natuition/Smoothieboard/N0127 SMOOTHIEBOARD MOTHERBOARD V10 RENDER.png

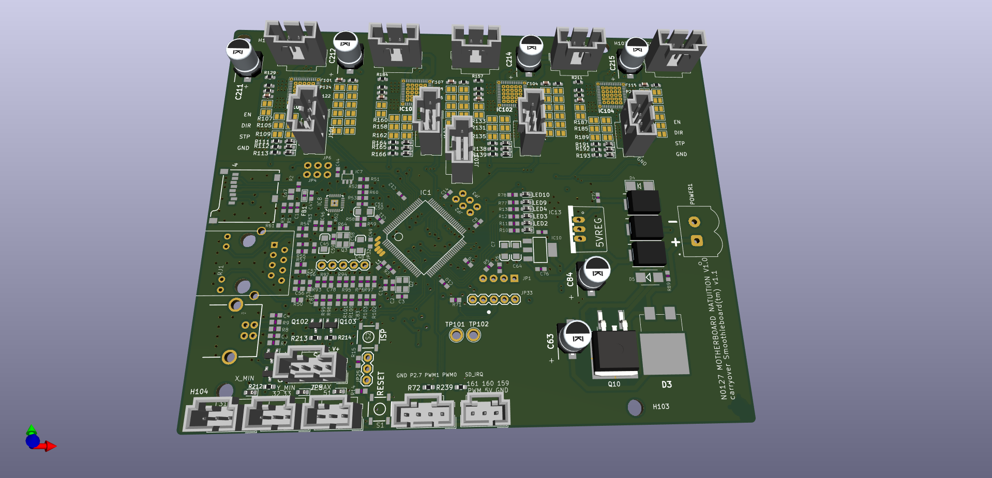
N0127 SMOOTHIEBOARD MOTHERBOARD V10 RENDER.png
