natuition/Smoothieboard/MOTHERBOARDV1.0 BOM TO PROTOELECTRONICS FROM RC3.xlsx

Ref | Qnty | Value | Fabricant | reference fabricant | Cmp name | Footprint | Description | Vendor
C1, C6, C8, C9, C10, C11, C12, C13, C14, C44, C46, C47, C51, C52, C53, C65, C76, C78, C79, C80, C81, C82, C83, | 23 | .1uF | Kyocera AVX | 0603ZC104KAT2A | C-EUC0603 | smoothieboard-5driver:C0603
C2, C3, C58, C59, | 4 | 12pF | MURATA | GJM0335G2A120GB01D | C-EUC0603 | smoothieboard-5driver:C0603
C4, C5, C54, C55, C56, C57, | 6 | 18pF | Kyocera AVX | 06035A180JAT2A | C-EUC0603 | smoothieboard-5driver:C0603
C7, C45, C50, C64, | 4 | 10uF | Kyocera AVX | TAJA106K016RNJ | CAP_POL1206 | smoothieboard-5driver:EIA3216
C48, | 1 | 1uF | Kyocera AVX | 08053C105JAT2A | CAP_POL1206 | smoothieboard-5driver:EIA3216
C49, | 1 | 470pF | Kyocera AVX | 06035A471JAT2A | C-EUC0603K | smoothieboard-5driver:C0603K
C63, C211, C212, C214, C215, C84 | 6 | 100uF | RUBYCON | 35TXV100M8X10.5 | EDK107M035A9HAA | SAMAC:CAPAE660X800N | Aluminum Electrolytic Capacitors - SMD 35V 100uF 20%
C67, | 1 | 1uF | Kyocera AVX | 08053C105JAT2A | C-EUC0805 | smoothieboard-5driver:C0805
C77, | 1 | .33uF | Kyocera AVX | 0603ZC334KAT2A | C-EUC0603 | smoothieboard-5driver:C0603
C101, C102, C104, C106, C107, C109, C115, C117, | 8 | 100n 6V3 | Kyocera AVX | 0603ZC104KAT2A | C-Device | Capacitor_SMD:C_0603_1608Metric_Pad1.08x0.95mm_HandSolder
D1, D2, D6, | 3 | MBRS330T3G | ON SEMI | MBRS330T3G | MBRS330T3G | SAMAC:DIOM7958X256N
D3, | 1 | VS-6TQ045S-M3 | VISHAY | VS-6TQ045S-M3 | VS-6TQ045S-M3 | SAMAC:VS6TQ045SM3 | Diode Schottky 45V 6A 3-Pin(2+Tab) D2PAK Tube
D4, | 1 | B1100-13-F | MULTICOMP PRO | B1100-13-F | DIODESMA | smoothieboard-5driver:SMADIODE
D5, | 1 | 15v | MCC | 3SMBJ5929B-TP | ZENER-DIODESMB | smoothieboard-5driver:SMB
D101, D102, D103, D104, D105, D106, D107, D108, D109, D110, D111, D112, LED1, LED2, LED3, LED4, LED9, LED10, LED101,LED102,LED103 | 21 | 150060SS75000 | WURTH ELEKTRONIK | 150060SS75000 | LED-Device | Diode_SMD:D_0603_1608Metric_Pad1.05x0.95mm_HandSolder
FB1, | 1 | FERRITE | Laird-Signal Integrity Products | LI0603G121R-10 | FERRITE | smoothieboard-5driver:0603
IC1, | 1 | LPC1769 | NATUITION | LPC1769 | LPC1768 | smoothieboard-5driver:LQFP100
IC7, | 1 | 74LVC1G04 | TI | SN74LVC1G04DBVR | 74LVC1G04 | smoothieboard-5driver:SOT23-5
IC8, | 1 | LAN8720 | NATUITION | 886-LAN8720AI-CP | LAN8720 | smoothieboard-5driver:QFN24_4MM
IC10, | 1 | LM1117-3.3V | NATUITION | LM1117IMP-3.3/NOPB | V_REG_LM1117SOT223 | smoothieboard-5driver:SOT223
IC13, | 1 | R-78E-5.0 | NATUITION | R-78E5.0-0.5 | R-78 | smoothieboard-5driver:R-78
IC101, IC102, IC103, IC104, | 4 | ~ | NATUITION | TB67S289FTG,EL | TB67S249FTG,EL-TB67S249FTG_EL | TB67S249FTG:QFN50P700X700X100-49N-D
J1, J2, J3, J4, J5, J101, J102, J103, J104, J105, J106, JP5 | 12 | SL 70543_0038 | MOLEX | 70543_0038 | M041X04_NO_SILK | Connector_Molex:Molex_SL_171971-0004_1x04_P2.54mm_Vertical
JP16, JP20, JP22, JP26, | 4 | SL 70543-0002 | MOLEX | 70543-0002 | M03POLAR | Connector_Molex:Molex_SL_171971-0003_1x03_P2.54mm_Vertical
L1, | 1 | INDUCTOR0603 | MURATA | LQW18AN39NJ8ZD | INDUCTOR0603 | smoothieboard-5driver:0603
POWER1, | 1 | 1146730000 | WEIDMULLER | 1148630000 | 1146730000 | OMNIMATE1148630000:1146730000
Q1, Q101,Q102,Q103 | 4 | CANAL P | NEXPERIA | BSS84,215 | BSL207SP | smoothieboard-5driver:SC74_INFINEON
Q2, | 1 | 12MHz | Kyocera AVX | CX3225SB12000H0FLJCC | CRYSTALTHIN | smoothieboard-5driver:CRYSTAL_3.2X2.5
Q3, | 1 | 25MHz | Kyocera AVX | CX3225SB25000H0FLJCC | CRYSTALTHIN | smoothieboard-5driver:CRYSTAL_3.2X2.5
Q10, | 1 | CANAL P | INFINEON | AUIRF4905S | SPD30P06PTO252 | smoothieboard-5driver:TO252
R1, R2, R3, R14, R15, R53, R62, R71, R89, R72, R239, R128, R156, R183, R210, | 15 | 10K | TE CONNECTIVITY | CRGCQ0603J10K | R-US_R0603 | smoothieboard-5driver:R0603
R5, R6, | 2 | 2.2k | MULTICOMP PRO | MC0603SAF2201T5E | R-US_R0603 | smoothieboard-5driver:R0603
R7, R52, | 2 | 1.5K | MULTICOMP PRO | MC0603SAF1501T5E | R-US_R0603 | smoothieboard-5driver:R0603
R8, R9, | 2 | 33R | PANASONIC | ERJ-UP3F33R0V | R-US_R0603 | smoothieboard-5driver:R0603
R10, R11, R12, R13, R77, R93, R94, R96, R98, R100, R102, R212,R213,214 | 14 | 1k | YAGEO | AC0603JR-071KL | R-US_R0603 | smoothieboard-5driver:R0603
R50, R61, | 2 | 330R | YAGEO | RC0603FR-07330RL | R-US_R0603 | smoothieboard-5driver:R0603
R51, R58, R59, R60, | 4 | 22R | PANASONIC | ERJ-UP3F22R0V | R-US_R0603 | smoothieboard-5driver:R0603
R54, R55, R56, R57, | 4 | 49.9R | YAGEO | RC0603FR-0749R9L | R-US_R0603 | smoothieboard-5driver:R0603
R63, | 1 | 12.1K | TE | CPF0603F12K1C1 | R-US_R0603 | smoothieboard-5driver:R0603
R64, | 1 | 1M | VISHAY | CRCW06031M00FKEAHP | R-US_R0603 | smoothieboard-5driver:R0603
R78, | 1 | 8.2K | MULTICOMP PRO | MC0603SAF8201T5E | R-US_R0603 | smoothieboard-5driver:R0603
R92, R95, R97, R99, R101, R103, | 6 | 5k6 | VISHAY | CRCW06035K60FKEA | R-US_R0603 | smoothieboard-5driver:R0603
R111, R112, R113, R137, R138, R139, R164, R165, R166, R191, R192, R193, | 12 | 470R | VISHAY | CRCW0603470RJNEBC | R-Device | Resistor_SMD:R_0603_1608Metric_Pad0.98x0.95mm_HandSolder
R126, R153, R180, R207, | 4 | 100K | PANASONIC | ERJ-3EKF1003V | R-Device | Resistor_SMD:R_0603_1608Metric_Pad0.98x0.95mm_HandSolder
R129, R157, R184, R211, | 4 | 50K | BOURNS | CR0603-FX-4992ELF | R-Device | Resistor_SMD:R_0603_1608Metric_Pad0.98x0.95mm_HandSolder
RJ1, | 1 | HR911105A | NATUITION | HR911105A | HR911105A | smoothieboard-5driver:HR911105A
S1, S2, | 2 | TAC_SWITCHSMD | CTS Electrocomponents | 223AMVAAR | TAC_SWITCHSMD | smoothieboard-5driver:TACTILE_SWITCH_SMD
U1, | 1 | USD-SOCKETNEW | GCT | MEM2061-01-188-00-A | USD-SOCKETNEW | smoothieboard-5driver:MICRO-SD-SOCKET-PP
X14, | 1 | USBPTH | SPARKFUN | PRT-00139 | USBPTH | smoothieboard-5driver:USB-B-PTH
