natuition/Smoothieboard/MOTHERBOARD.kicad_sch

## KiCad design MOTHERBOARD.kicad_sch (2022-07-20)

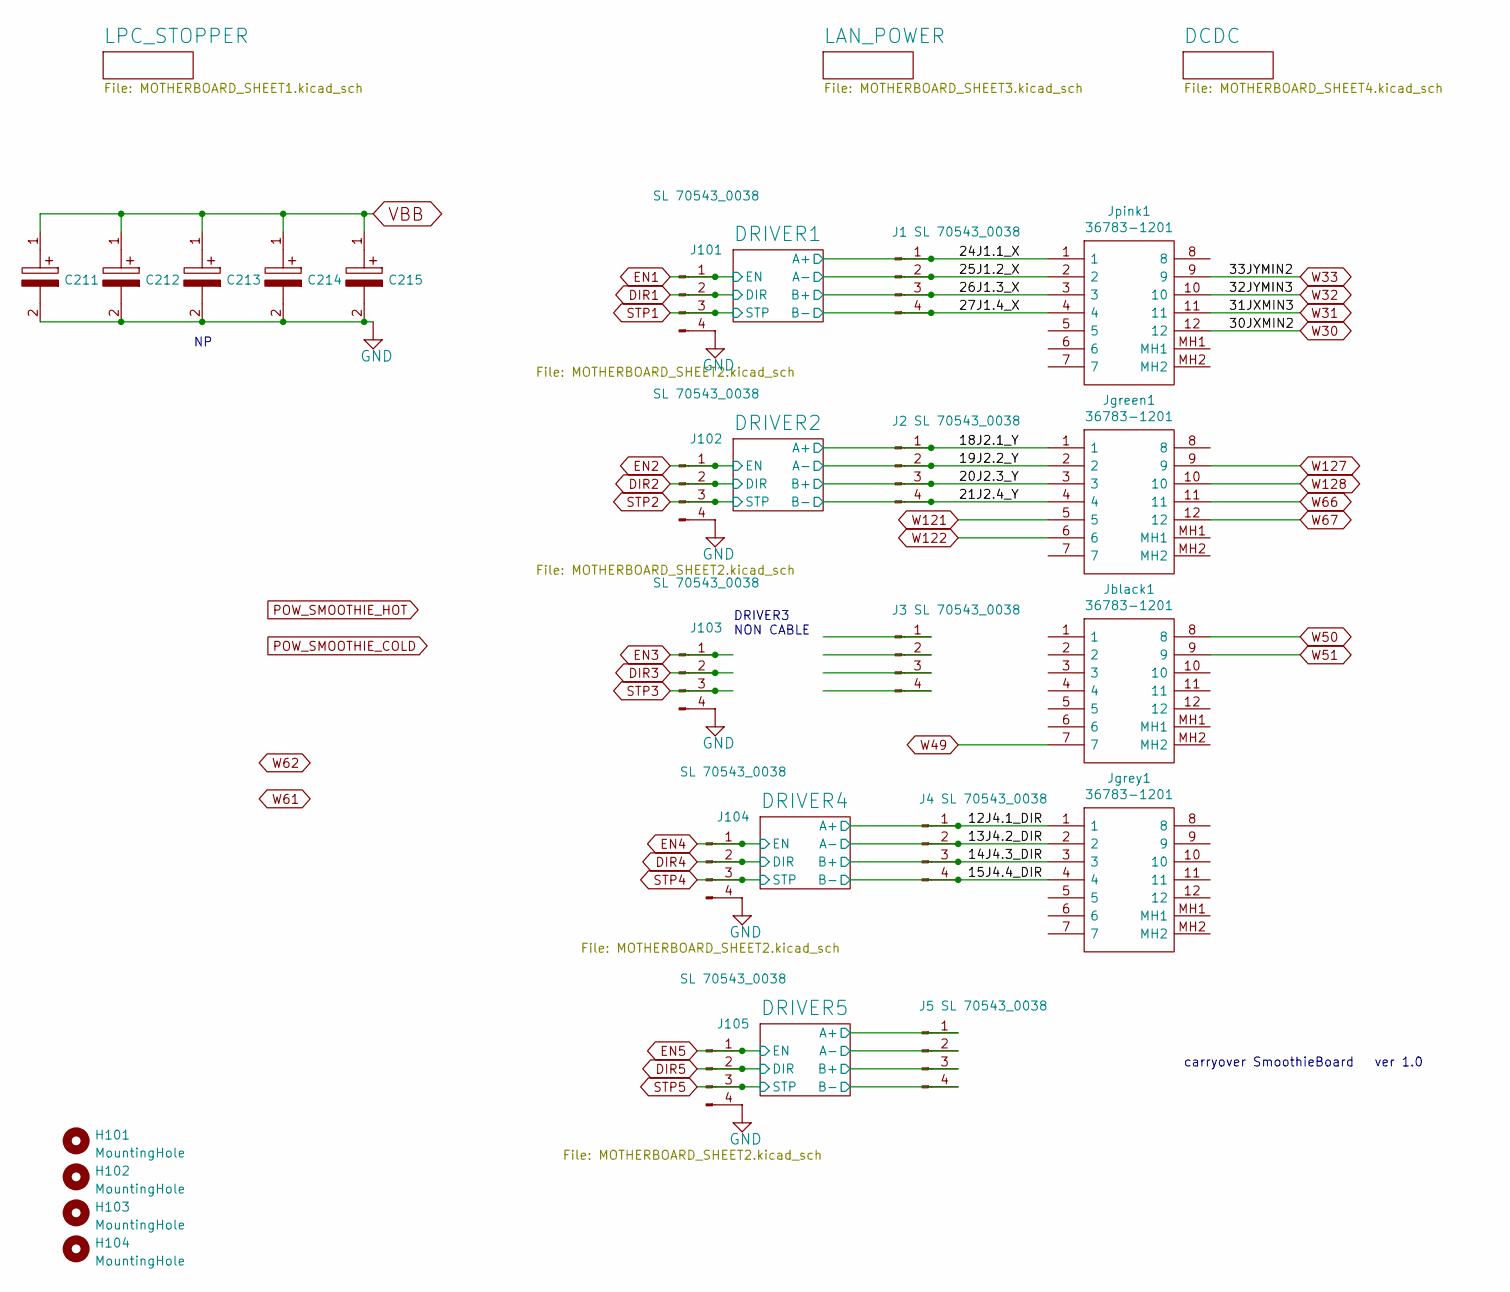
[picture p2: schematic MOTHERBOARD.kicad_sch]

Parts:
C211, C212, C214, C215: EDK107M035A9HAA; CAPAE660X800N; Mouser Part Number 80-EDK107M035A9HAA
C213: EDK107M035A9HAA; Mouser Part Number 80-EDK107M035A9HAA
H101, H102, H103, H104: MountingHole; MountingHole_3.7mm_NATUITION_SMOOTHIE
J1, J2, J3, J4, J5, J101, J102, J103, J104, J105: SL 70543_0038; Molex_SL_171971-0004_1x04_P2.54mm_Vertical
Jblack1: 36783-1201; 367831201; Mouser Part Number 538-36783-1201
Jgreen1: 36783-1201; 367831201; Mouser Part Number 538-36783-1201
Jgrey1: 36783-1201; 367831201; Mouser Part Number 538-36783-1201
Jpink1: 36783-1201; 367831201; Mouser Part Number 538-36783-1201

Connections:
12J4.1_DIR: J4.1, Jgrey1.1
13J4.2_DIR: J4.2, Jgrey1.2
14J4.3_DIR: J4.3, Jgrey1.3
15J4.4_DIR: J4.4, Jgrey1.4
18J2.1_Y: J2.1, Jgreen1.1
19J2.2_Y: J2.2, Jgreen1.2
20J2.3_Y: J2.3, Jgreen1.3
21J2.4_Y: J2.4, Jgreen1.4
24J1.1_X: J1.1, Jpink1.1
25J1.2_X: J1.2, Jpink1.2
26J1.3_X: J1.3, Jpink1.3
27J1.4_X: J1.4, Jpink1.4
A+: J5.1
A-: J5.2
B+: J5.3
B-: J5.4
DIR1: J101.2
DIR2: J102.2
DIR3: J103.2
DIR4: J104.2
DIR5: J105.2
EN1: J101.1
EN2: J102.1
EN3: J103.1
EN4: J104.1
EN5: J105.1
GND: C211.2, C212.2, C213.2, C214.2, C215.2, J101.4, J102.4, J103.4, J104.4, J105.4
STP1: J101.3
STP2: J102.3
STP3: J103.3
STP4: J104.3
STP5: J105.3
VBB: C211.1, C212.1, C213.1, C214.1, C215.1
W30: Jpink1.12
W31: Jpink1.11
W32: Jpink1.10
W33: Jpink1.9
W49: Jblack1.7
W50: Jblack1.8
W51: Jblack1.9
W66: Jgreen1.11
W67: Jgreen1.12
W121: Jgreen1.5
W122: Jgreen1.6
W127: Jgreen1.9
W128: Jgreen1.10

Notes on the sheet:
carryover SmoothieBoard ver 1.0
DRIVER3 NON CABLE
