natuition/Smoothieboard/MOTHERBOARD_SHEET1.kicad_sch

## KiCad design MOTHERBOARD_SHEET1.kicad_sch (2022-07-20)

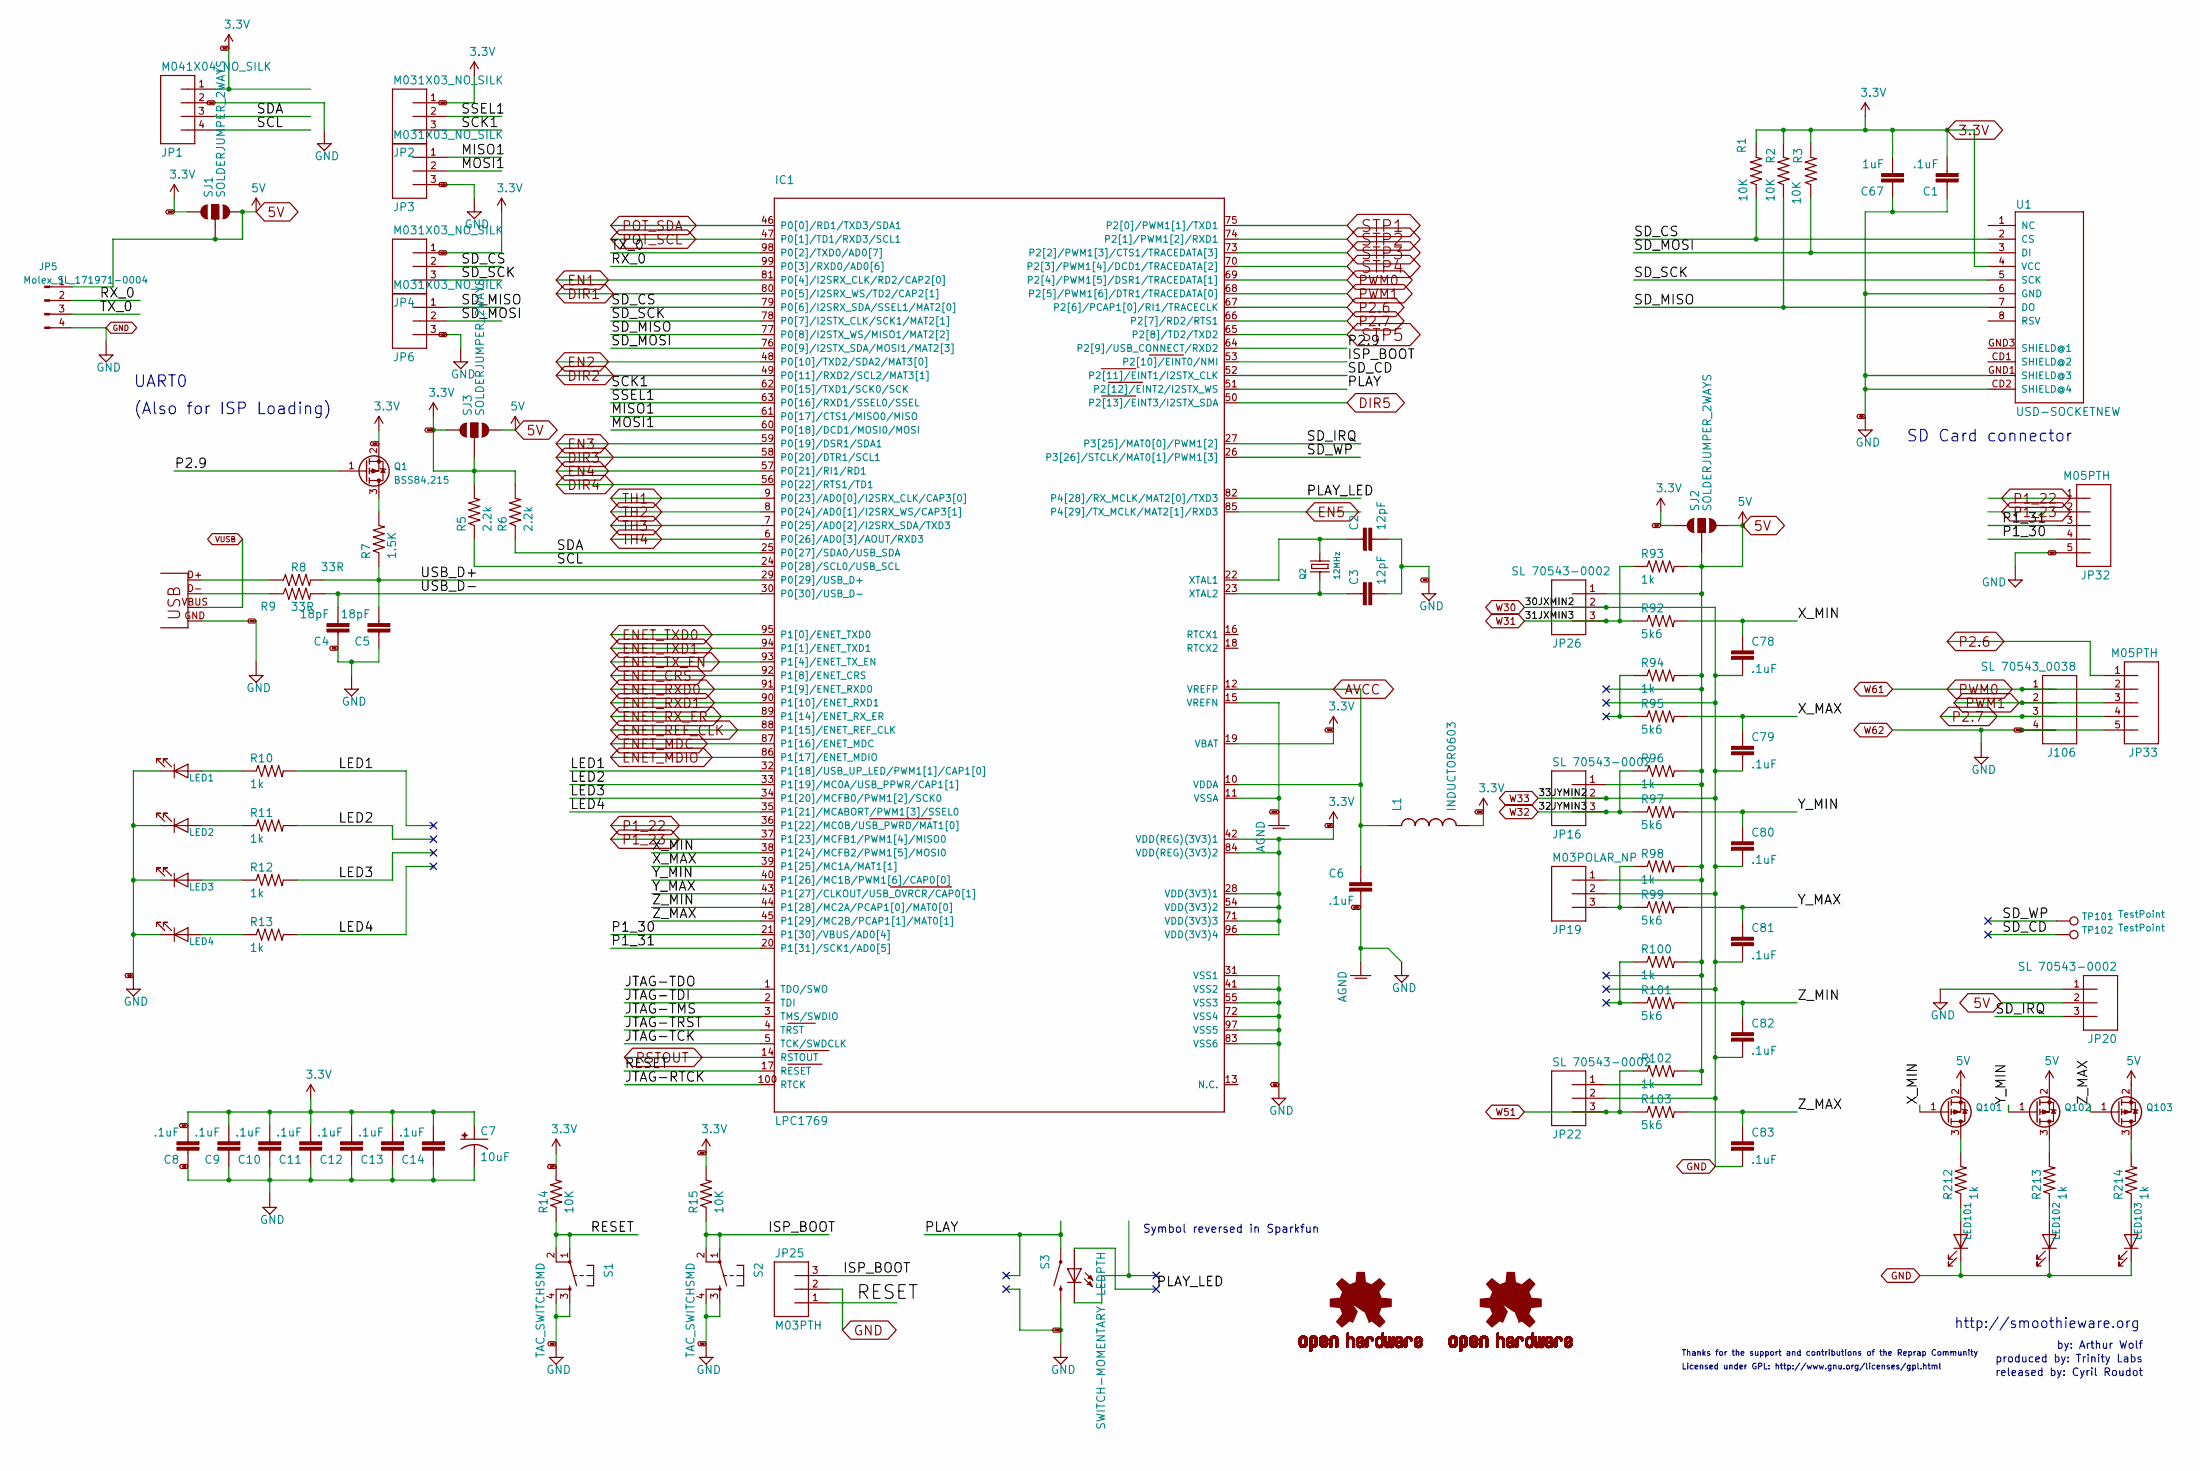
[picture p3: schematic MOTHERBOARD_SHEET1.kicad_sch]

Parts:
C1, C6, C8, C9, C10, C11, C12, C13, C14, C78, C79, C80, C81, C82, C83: .1uF; C0603
C2, C3: 12pF; C0603
C4, C5: 18pF; C0603
C7: 10uF; EIA3216
C67: 1uF; C0805
IC1: LPC1769; LQFP100
J106: SL 70543_0038; Molex_SL_171971-0004_1x04_P2.54mm_Vertical
JP1: M041X04_NO_SILK; 1X04_NO_SILK
JP2, JP3, JP4, JP6: M031X03_NO_SILK; 1X03_NO_SILK
JP5: Molex_SL_171971-0004; Molex_SL_171971-0004_1x04_P2.54mm_Vertical
JP16, JP20, JP22, JP26: SL 70543-0002; Molex_SL_171971-0003_1x03_P2.54mm_Vertical
JP19: M03POLAR_NP
JP25: M03PTH; 1X03
JP32, JP33: M05PTH; 1X05
L1: INDUCTOR0603; 0603
LED1, LED2, LED3, LED4, LED101, LED102, LED103: 150060SS75000; D_0603_1608Metric_Pad1.05x0.95mm_HandSolder
Q1, Q101, Q102, Q103: BSS84,215; SOT-23
Q2: 12MHz; CRYSTAL_3.2X2.5
R1, R2, R3, R14, R15: 10K; R0603
R5, R6: 2.2k; R0603
R7: 1.5K; R0603
R8, R9: 33R; R0603
R10, R11, R12, R13, R93, R94, R96, R98, R100, R102: 1k; R0603
R92, R95, R97, R99, R101, R103: 5k6; R0603
R212, R213, R214: 1k; R_0603_1608Metric_Pad0.98x0.95mm_HandSolder
S1, S2: TAC_SWITCHSMD; TACTILE_SWITCH_SMD
S3: SWITCH-MOMENTARY-LEDPTH
SJ1, SJ2, SJ3: SOLDERJUMPER_2WAYS; SJ_3
TP101, TP102: TestPoint; TestPoint_Plated_Hole_D2.0mm
U1: USD-SOCKETNEW; MICRO-SD-SOCKET-PP
U$101, U$102: OSHW-LOGOH; OSHW-LOGO-HUGE
X14: USBPTH; USB-B-PTH

Connections:
3.3V: C1.2, C7.A (+), C8.2, C9.2, C10.2, C11.2, C12.2, C13.2, C14.2, C67.2, IC1.19 (VBAT), IC1.28 (VDD(3V3)1), IC1.42 (VDD(REG)(3V3)1), IC1.54 (VDD(3V3)2), IC1.71 (VDD(3V3)3), IC1.84 (VDD(REG)(3V3)2), IC1.96 (VDD(3V3)4), JP1.1, JP2.1, JP4.1, L1.2, Q1.2 (S), R1.2, R2.2, R3.2, R5.2, R6.2, R14.2, R15.2, SJ1.1, SJ2.1, SJ3.1, SJ3.2, U1.4 (VCC)
5V: JP5.1, JP16.1, JP19.1, JP20.2, JP22.1, JP26.1, Q101.2 (S), Q102.2 (S), Q103.2 (S), R93.2, R94.2, R96.2, R98.2, R100.2, R102.2, SJ1.2, SJ1.3, SJ2.2, SJ2.3, SJ3.3
AGND: C1.1, C2.2, C3.2, C4.1, C5.1, C6.2, C7.C (-), C8.1, C9.1, C10.1, C11.1, C12.1, C13.1, C14.1, C67.1, C78.2, C79.2, C80.2, C81.2, C82.2, C83.2, IC1.11 (VSSA), IC1.15 (VREFN), IC1.31 (VSS1), IC1.41 (VSS2), IC1.55 (VSS3), IC1.72 (VSS4), IC1.83 (VSS6), IC1.97 (VSS5), J106.4, JP1.2, JP3.3, JP5.4, JP6.3, JP16.2, JP19.2, JP20.1, JP22.2, JP25.2, JP26.2, JP32.5, JP33.5, LED1.1 (K), LED2.1 (K), LED3.1 (K), LED4.1 (K), LED101.1 (K), LED102.1 (K), LED103.1 (K), S1.3, S1.4, S2.3, S2.4, S3.2, U1.6 (GND), U1.CD2 (SHIELD@4), U1.GND1 (SHIELD@3), X14.GND
AVCC: C6.1, IC1.10 (VDDA), IC1.12 (VREFP), L1.1
DIR1: IC1.80 (P0[5]/I2SRX_WS/TD2/CAP2[1])
DIR2: IC1.49 (P0[11]/RXD2/SCL2/MAT3[1])
DIR3: IC1.58 (P0[20]/DTR1/SCL1)
DIR4: IC1.56 (P0[22]/RTS1/TD1)
DIR5: IC1.50 (P2[13]/EINT3/I2STX_SDA)
EN1: IC1.81 (P0[4]/I2SRX_CLK/RD2/CAP2[0])
EN2: IC1.48 (P0[10]/TXD2/SDA2/MAT3[0])
EN3: IC1.59 (P0[19]/DSR1/SDA1)
EN4: IC1.57 (P0[21]/RI1/RD1)
EN5: IC1.85 (P4[29]/TX_MCLK/MAT2[1]/RXD3)
ENET_CRS: IC1.92 (P1[8]/ENET_CRS)
ENET_MDC: IC1.87 (P1[16]/ENET_MDC)
ENET_MDIO: IC1.86 (P1[17]/ENET_MDIO)
ENET_REF_CLK: IC1.88 (P1[15]/ENET_REF_CLK)
ENET_RXD0: IC1.91 (P1[9]/ENET_RXD0)
ENET_RXD1: IC1.90 (P1[10]/ENET_RXD1)
ENET_RX_ER: IC1.89 (P1[14]/ENET_RX_ER)
ENET_TXD0: IC1.95 (P1[0]/ENET_TXD0)
ENET_TXD1: IC1.94 (P1[1]/ENET_TXD1)
ENET_TX_EN: IC1.93 (P1[4]/ENET_TX_EN)
ISP_BOOT: IC1.53 (P2[10]/EINT0/NMI), JP25.3, R15.1, S2.1, S2.2
JTAG-RTCK: IC1.100 (RTCK)
JTAG-TCK: IC1.5 (TCK/SWDCLK)
JTAG-TDI: IC1.2 (TDI)
JTAG-TDO: IC1.1 (TDO/SWO)
JTAG-TMS: IC1.3 (TMS/SWDIO)
JTAG-TRST: IC1.4 (TRST)
LED1: IC1.32 (P1[18]/USB_UP_LED/PWM1[1]/CAP1[0]), R10.2
LED2: IC1.33 (P1[19]/MC0A/USB_PPWR/CAP1[1]), R11.2
LED3: IC1.34 (P1[20]/MCFB0/PWM1[2]/SCK0), R12.2
LED4: IC1.35 (P1[21]/MCABORT/PWM1[3]/SSEL0), R13.2
MISO1: IC1.61 (P0[17]/CTS1/MISO0/MISO), JP3.1
MOSI1: IC1.60 (P0[18]/DCD1/MOSI0/MOSI), JP3.2
unnamed: C2.1, IC1.22 (XTAL1), Q2.2
unnamed: C3.1, IC1.23 (XTAL2), Q2.1
unnamed: JP19.3, R98.1, R99.1
unnamed: LED1.2 (A), R10.1
unnamed: LED2.2 (A), R11.1
unnamed: LED3.2 (A), R12.1
unnamed: LED4.2 (A), R13.1
unnamed: LED101.2 (A), R212.1
unnamed: LED102.2 (A), R213.1
unnamed: LED103.2 (A), R214.1
unnamed: Q1.3 (D), R7.2
unnamed: Q101.3 (D), R212.2
unnamed: Q102.3 (D), R213.2
unnamed: Q103.3 (D), R214.2
unnamed: R8.1, X14.D+
unnamed: R9.1, X14.D-
unnamed: R94.1, R95.1
unnamed: R100.1, R101.1
P1_22: IC1.36 (P1[22]/MC0B/USB_PWRD/MAT1[0]), JP32.1
P1_23: IC1.37 (P1[23]/MCFB1/PWM1[4]/MISO0), JP32.2
P1_30: IC1.21 (P1[30]/VBUS/AD0[4]), JP32.4
P1_31: IC1.20 (P1[31]/SCK1/AD0[5]), JP32.3
P2.6: IC1.67 (P2[6]/PCAP1[0]/RI1/TRACECLK), JP33.1
P2.7: IC1.66 (P2[7]/RD2/RTS1), J106.3, JP33.4
P2.9: IC1.64 (P2[9]/USB_CONNECT/RXD2), Q1.1 (G)
PLAY: IC1.51 (P2[12]/EINT2/I2STX_WS), S3.4 (1)
PLAY_LED: IC1.82 (P4[28]/RX_MCLK/MAT2[0]/TXD3), S3.A
POT_SCL: IC1.47 (P0[1]/TD1/RXD3/SCL1)
POT_SDA: IC1.46 (P0[0]/RD1/TXD3/SDA1)
PWM0: IC1.69 (P2[4]/PWM1[5]/DSR1/TRACEDATA[1]), J106.1, JP33.2
PWM1: IC1.68 (P2[5]/PWM1[6]/DTR1/TRACEDATA[0]), J106.2, JP33.3
RESET: IC1.17 (RESET), JP25.1, R14.1, S1.1, S1.2
RSTOUT: IC1.14 (RSTOUT)
RX_0: IC1.99 (P0[3]/RXD0/AD0[6]), JP5.2
SCK1: IC1.62 (P0[15]/TXD1/SCK0/SCK), JP2.3
SCL: IC1.24 (P0[28]/SCL0/USB_SCL), JP1.4, R5.1
SDA: IC1.25 (P0[27]/SDA0/USB_SDA), JP1.3, R6.1
SD_CD: IC1.52 (P2[11]/EINT1/I2STX_CLK), TP102.1
SD_CS: IC1.79 (P0[6]/I2SRX_SDA/SSEL1/MAT2[0]), JP4.2, R1.1, U1.2 (CS)
SD_IRQ: IC1.27 (P3[25]/MAT0[0]/PWM1[2]), JP20.3
SD_MISO: IC1.77 (P0[8]/I2STX_WS/MISO1/MAT2[2]), JP6.1, R2.1, U1.7 (DO)
SD_MOSI: IC1.76 (P0[9]/I2STX_SDA/MOSI1/MAT2[3]), JP6.2, R3.1, U1.3 (DI)
SD_SCK: IC1.78 (P0[7]/I2STX_CLK/SCK1/MAT2[1]), JP4.3, U1.5 (SCK)
SD_WP: IC1.26 (P3[26]/STCLK/MAT0[1]/PWM1[3]), TP101.1
SSEL1: IC1.63 (P0[16]/RXD1/SSEL0/SSEL), JP2.2
STP1: IC1.75 (P2[0]/PWM1[1]/TXD1)
STP2: IC1.74 (P2[1]/PWM1[2]/RXD1)
STP3: IC1.73 (P2[2]/PWM1[3]/CTS1/TRACEDATA[3])
STP4: IC1.70 (P2[3]/PWM1[4]/DCD1/TRACEDATA[2])
STP5: IC1.65 (P2[8]/TD2/TXD2)
TH1: IC1.9 (P0[23]/AD0[0]/I2SRX_CLK/CAP3[0])
TH2: IC1.8 (P0[24]/AD0[1]/I2SRX_WS/CAP3[1])
TH3: IC1.7 (P0[25]/AD0[2]/I2SRX_SDA/TXD3)
TH4: IC1.6 (P0[26]/AD0[3]/AOUT/RXD3)
TX_0: IC1.98 (P0[2]/TXD0/AD0[7]), JP5.3
USB_D+: C5.2, IC1.29 (P0[29]/USB_D+), R7.1, R8.2
USB_D-: C4.2, IC1.30 (P0[30]/USB_D-), R9.2
VUSB: X14.VBUS
W31: JP26.3, R92.1, R93.1
W32: JP16.3, R96.1, R97.1
W51: JP22.3, R102.1, R103.1
X_MAX: C79.1, IC1.39 (P1[25]/MC1A/MAT1[1]), R95.2
X_MIN: C78.1, IC1.38 (P1[24]/MCFB2/PWM1[5]/MOSI0), Q101.1 (G), R92.2
Y_MAX: C81.1, IC1.43 (P1[27]/CLKOUT/USB_OVRCR/CAP0[1]), R99.2
Y_MIN: C80.1, IC1.40 (P1[26]/MC1B/PWM1[6]/CAP0[0]), Q102.1 (G), R97.2
Z_MAX: C83.1, IC1.45 (P1[29]/MC2B/PCAP1[1]/MAT0[1]), Q103.1 (G), R103.2
Z_MIN: C82.1, IC1.44 (P1[28]/MC2A/PCAP1[0]/MAT0[0]), R101.2

Notes on the sheet:
(Also for ISP Loading)
Thanks for the support and contributions of the Reprap Community
SD Card connector
http://smoothieware.org
UART0
released by: Cyril Roudot
Licensed under GPL: http://www.gnu.org/licenses/gpl.html
by: Arthur Wolf
Symbol reversed in Sparkfun
produced by: Trinity Labs
