natuition/Smoothieboard/MOTHERBOARD_SHEET2.kicad_sch

## KiCad design MOTHERBOARD_SHEET2.kicad_sch (2022-07-20)

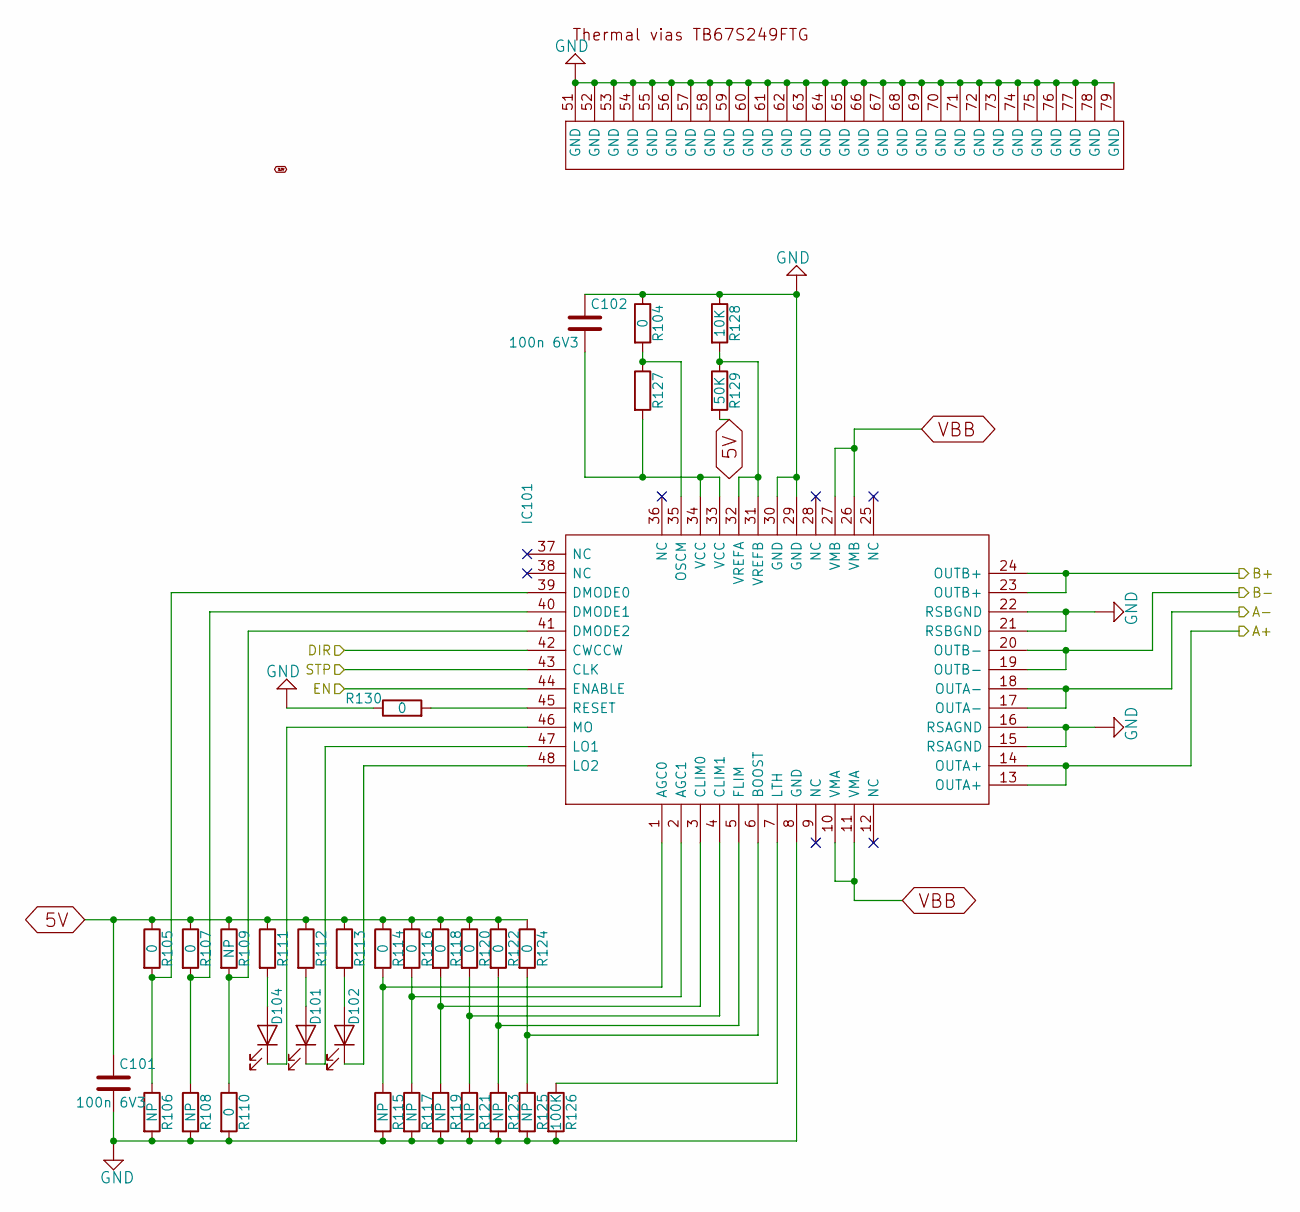
[picture p4: schematic MOTHERBOARD_SHEET2.kicad_sch]

Parts:
C101, C102: 100n 6V3; C_0603_1608Metric_Pad1.08x0.95mm_HandSolder
D101, D102, D104: 150060SS75000; D_0603_1608Metric_Pad1.05x0.95mm_HandSolder
IC101: QFN50P700X700X100-49N-D; Mouser Part Number 757-TB67S249FTGEL
R104, R105, R107, R110, R114, R116, R118, R120, R122, R124, R130: 0; SolderJumper-2_P1.3mm_Bridged_Pad1.0x1.5mm
R106, R108: NP; SolderJumper-2_P1.3mm_Bridged_Pad1.0x1.5mm
R109, R115, R117, R119, R121, R123, R125: NP; SolderJumper-2_P1.3mm_Open_Pad1.0x1.5mm
R111, R112, R113: CRCW0603470RJNEBC; R_0603_1608Metric_Pad0.98x0.95mm_HandSolder
R126: 100K; R_0603_1608Metric_Pad0.98x0.95mm_HandSolder
R127: R_0603_1608Metric_Pad0.98x0.95mm_HandSolder
R128: 10K; R_0603_1608Metric_Pad0.98x0.95mm_HandSolder
R129: 50K; R_0603_1608Metric_Pad0.98x0.95mm_HandSolder

Connections:
5V: C101.1, R105.1, R107.1, R109.1, R111.1, R112.1, R113.1, R114.1, R116.1, R118.1, R120.1, R122.1, R124.1, R129.2
A+: IC101.13 (OUTA+), IC101.14 (OUTA+)
A-: IC101.17 (OUTA-), IC101.18 (OUTA-)
B+: IC101.23 (OUTB+), IC101.24 (OUTB+)
B-: IC101.19 (OUTB-), IC101.20 (OUTB-)
DIR: IC101.42 (CWCCW)
EN: IC101.44 (ENABLE)
GND: C101.2, C102.1, IC101.8 (GND), IC101.15 (RSAGND), IC101.16 (RSAGND), IC101.21 (RSBGND), IC101.22 (RSBGND), IC101.29 (GND), IC101.30 (GND), IC101.51 (GND), IC101.52 (GND), IC101.53 (GND), IC101.54 (GND), IC101.55 (GND), IC101.56 (GND), IC101.57 (GND), IC101.58 (GND), IC101.59 (GND), IC101.60 (GND), IC101.61 (GND), IC101.62 (GND), IC101.63 (GND), IC101.64 (GND), IC101.65 (GND), IC101.66 (GND), IC101.67 (GND), IC101.68 (GND), IC101.69 (GND), IC101.70 (GND), IC101.71 (GND), IC101.72 (GND), IC101.73 (GND), IC101.74 (GND), IC101.75 (GND), IC101.76 (GND), IC101.77 (GND), IC101.78 (GND), IC101.79 (GND), R104.1, R106.2, R108.2, R110.2, R115.2, R117.2, R119.2, R121.2, R123.2, R125.2, R126.2, R128.1, R130.1
unnamed: C102.2, IC101.33 (VCC), IC101.34 (VCC), R127.2
unnamed: D101.1 (K), IC101.47 (LO1)
unnamed: D101.2 (A), R112.2
unnamed: D102.1 (K), IC101.48 (LO2)
unnamed: D102.2 (A), R113.2
unnamed: D104.1 (K), IC101.46 (MO)
unnamed: D104.2 (A), R111.2
unnamed: IC101.1 (AGC0), R114.2, R115.1
unnamed: IC101.2 (AGC1), R116.2, R117.1
unnamed: IC101.3 (CLIM0), R118.2, R119.1
unnamed: IC101.4 (CLIM1), R120.2, R121.1
unnamed: IC101.5 (FLIM), R122.2, R123.1
unnamed: IC101.6 (BOOST), R124.2, R125.1
unnamed: IC101.7 (LTH), R126.1
unnamed: IC101.31 (VREFB), IC101.32 (VREFA), R128.2, R129.1
unnamed: IC101.35 (OSCM), R104.2, R127.1
unnamed: IC101.39 (DMODE0), R105.2, R106.1
unnamed: IC101.40 (DMODE1), R107.2, R108.1
unnamed: IC101.41 (DMODE2), R109.2, R110.1
unnamed: IC101.45 (RESET), R130.2
STP: IC101.43 (CLK)
VBB: IC101.10 (VMA), IC101.11 (VMA), IC101.26 (VMB), IC101.27 (VMB)
