natuition/Smoothieboard/MOTHERBOARD_SHEET3.kicad_sch

## KiCad design MOTHERBOARD_SHEET3.kicad_sch (2022-07-20)

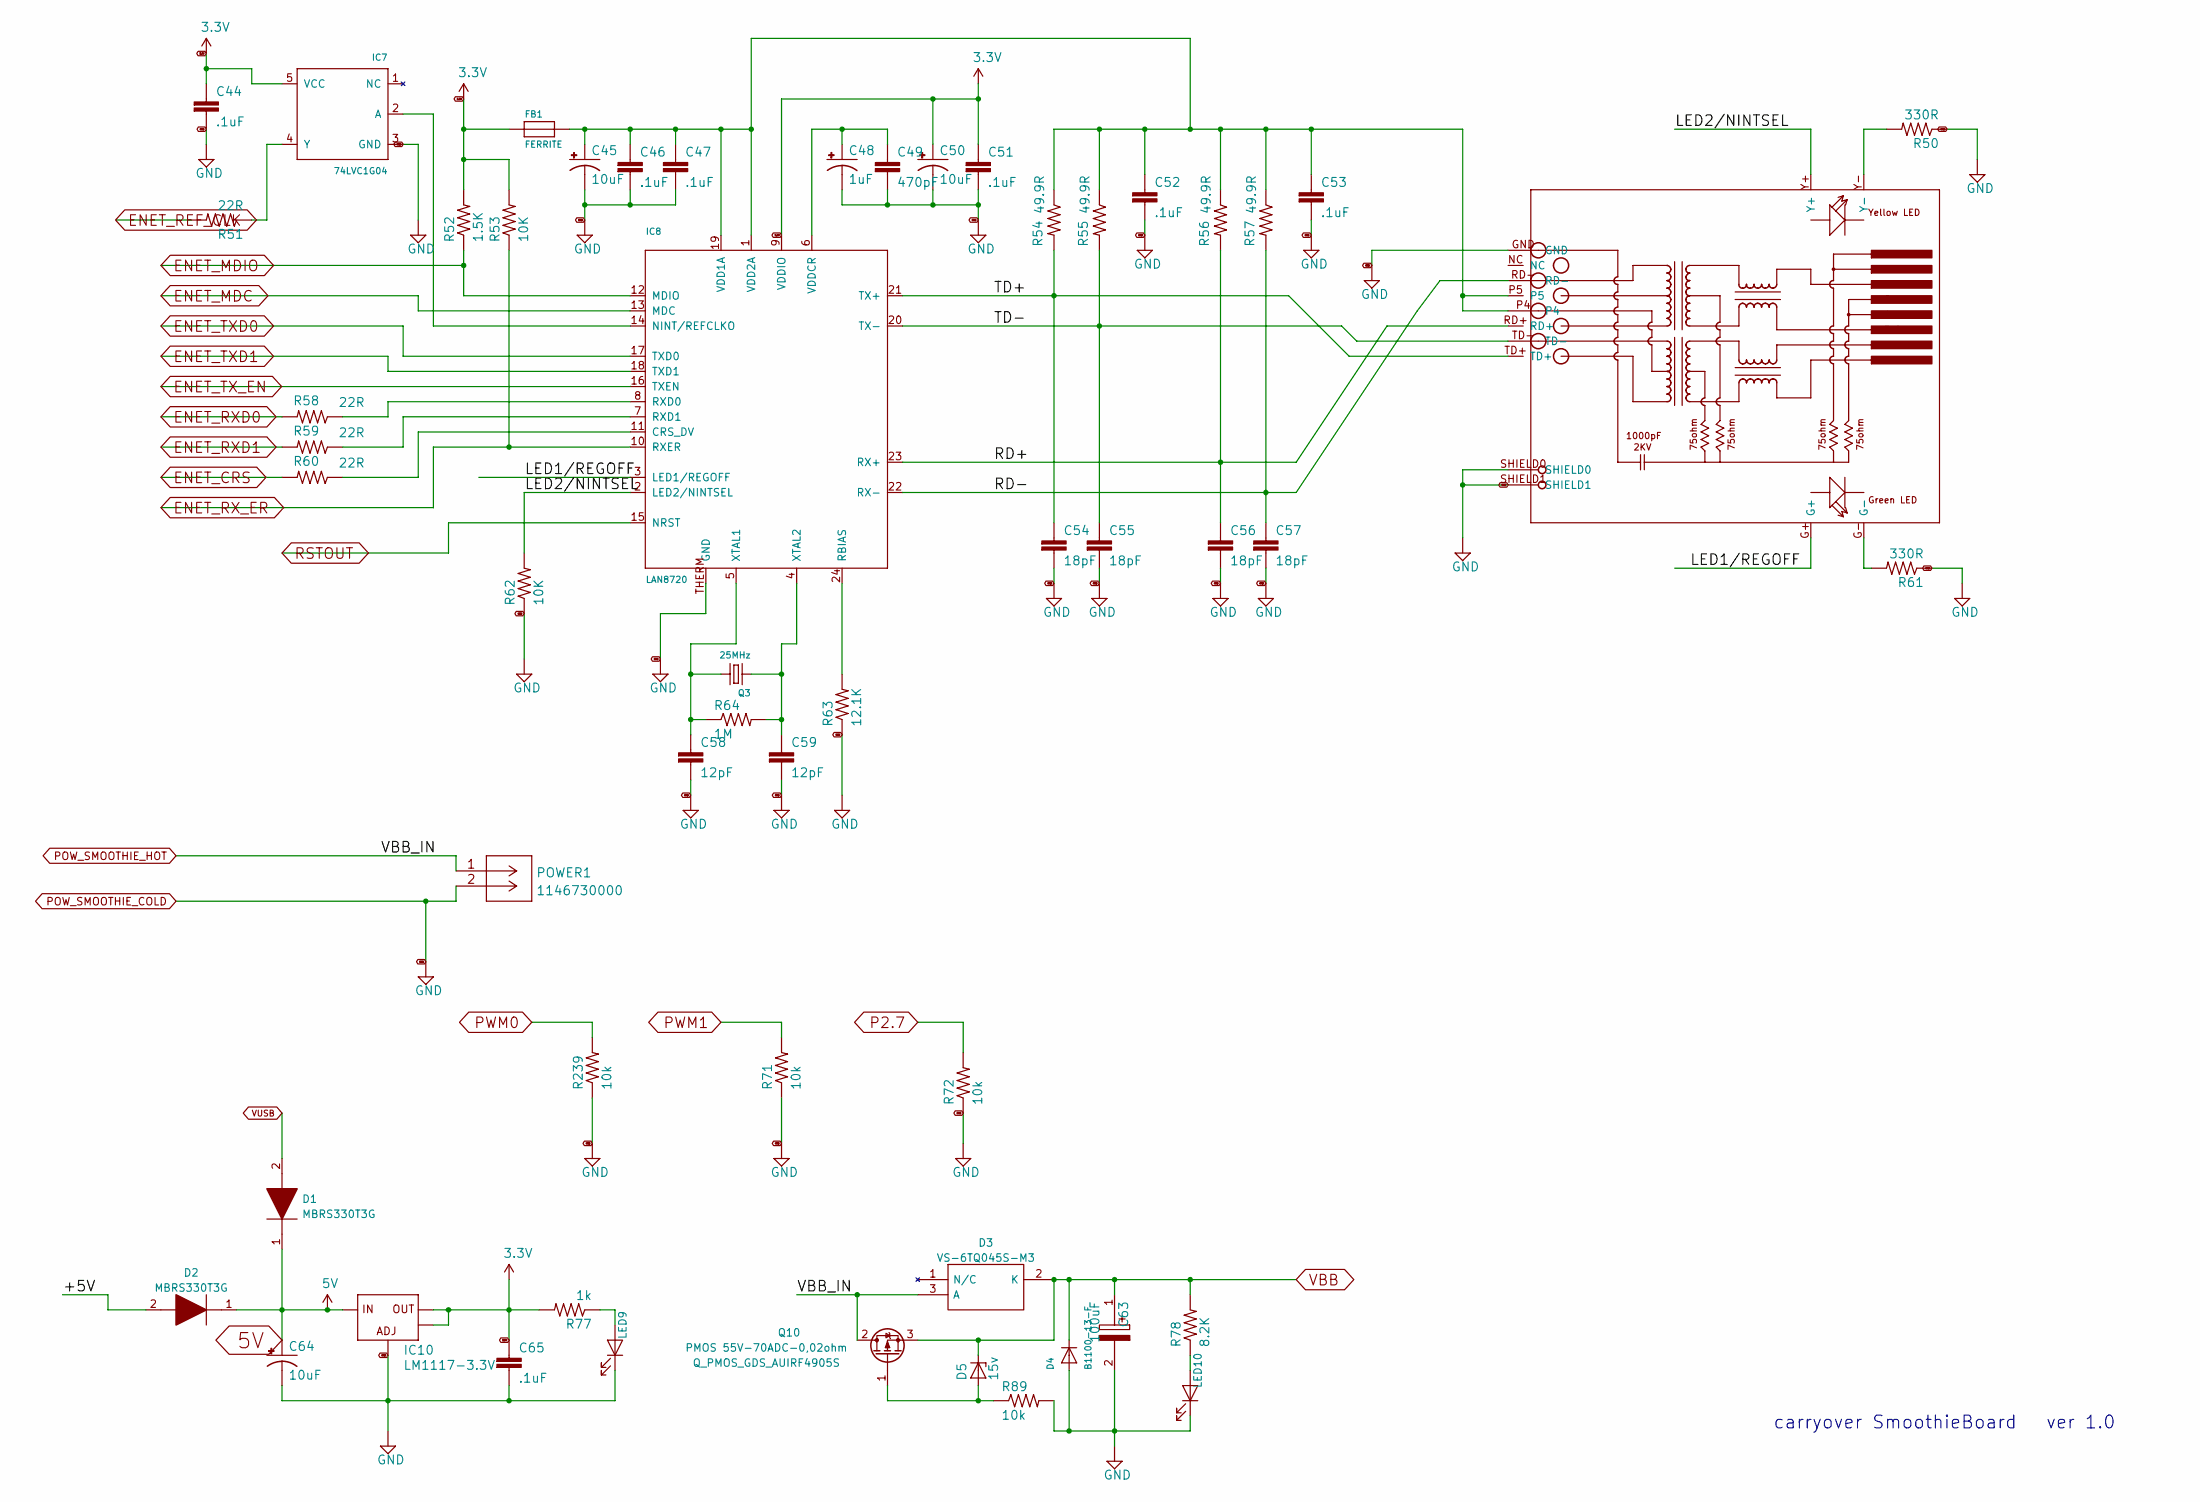
[picture p5: schematic MOTHERBOARD_SHEET3.kicad_sch]

Parts:
C44, C46, C47, C51, C52, C53, C65: .1uF; C0603
C45, C50, C64: 10uF; EIA3216
C48: 1uF; EIA3216
C49: 470pF; C0603K
C54, C55, C56, C57: 18pF; C0603
C58, C59: 12pF; C0603
C63: 100uF; CAPAE660X800N; Mouser Part Number 80-EDK107M035A9HAA
D1, D2: MBRS330T3G; DIOM7958X256N; Mouser Part Number 863-MBRS330T3G
D3: VS-6TQ045S-M3; VS6TQ045SM3; Mouser Part Number 78-VS-6TQ045S-M3
D4: B1100-13-F; SMADIODE
D5: 15v; SMB
FB1: FERRITE; 0603
IC7: 74LVC1G04; SOT23-5
IC8: LAN8720; QFN24_4MM
IC10: LM1117-3.3V; SOT223
LED9, LED10: 150060SS75000; D_0603_1608Metric_Pad1.05x0.95mm_HandSolder
POWER1: 1146730000
Q3: 25MHz; CRYSTAL_3.2X2.5
Q10: Q_PMOS_GDS_AUIRF4905S; TO-263-2
R50, R61: 330R; R0603
R51, R58, R59, R60: 22R; R0603
R52: 1.5K; R0603
R53, R62: 10K; R0603
R54, R55, R56, R57: 49.9R; R0603
R63: 12.1K; R0603
R64: 1M; R0603
R71, R89: 10k; R0603
R72, R239: 10k; R_0603_1608Metric_Pad0.98x0.95mm_HandSolder
R77: 1k; R0603
R78: 8.2K; R0603
RJ1: HR911105A

Connections:
3.3V: C44.1, C50.A (+), C51.1, C65.1, FB1.1, IC7.5 (VCC), IC8.9 (VDDIO), IC10.2 (OUT), IC10.4 (OUT@1), R52.2, R53.2, R77.2
5V: C64.A (+), D1.1, D2.1, IC10.3 (IN)
+5V: D2.2
ENET_CRS: R60.2
ENET_MDC: IC8.13 (MDC)
ENET_MDIO: IC8.12 (MDIO), R52.1
ENET_REF_CLK: R51.2
ENET_RXD0: R58.2
ENET_RXD1: R59.2
ENET_RX_ER: IC8.10 (RXER), R53.1
ENET_TXD0: IC8.17 (TXD0)
ENET_TXD1: IC8.18 (TXD1)
ENET_TX_EN: IC8.16 (TXEN)
GND: C44.2, C45.C (-), C46.2, C47.2, C48.C (-), C49.2, C50.C (-), C51.2, C52.2, C53.2, C54.2, C55.2, C56.2, C57.2, C58.2, C59.2, C63.2, C64.C (-), C65.2, D4.A, IC7.3 (GND), IC8.THERM (GND), IC10.1 (ADJ), LED9.1 (K), LED10.1 (K), POWER1.2, R50.1, R61.1, R62.1, R63.1, R71.1, R72.1, R89.2, R239.1, RJ1.GND, RJ1.SHIELD0, RJ1.SHIELD1
LED1/REGOFF: IC8.3 (LED1/REGOFF), RJ1.G+
LED2/NINTSEL: IC8.2 (LED2/NINTSEL), R62.2, RJ1.Y+
unnamed: C45.A (+), C46.1, C47.1, C52.1, C53.1, FB1.2, IC8.1 (VDD2A), IC8.19 (VDD1A), R54.1, R55.1, R56.1, R57.1, RJ1.P4, RJ1.P5
unnamed: C48.A (+), C49.1, IC8.6 (VDDCR)
unnamed: C58.1, IC8.5 (XTAL1), Q3.2, R64.1
unnamed: C59.1, IC8.4 (XTAL2), Q3.1, R64.2
unnamed: D5.A, Q10.1 (G), R89.1
unnamed: IC7.2 (A), IC8.14 (NINT/REFCLKO)
unnamed: IC7.4 (Y), R51.1
unnamed: IC8.7 (RXD1), R59.1
unnamed: IC8.8 (RXD0), R58.1
unnamed: IC8.11 (CRS_DV), R60.1
unnamed: IC8.24 (RBIAS), R63.2
unnamed: LED9.2 (A), R77.1
unnamed: LED10.2 (A), R78.1
unnamed: R50.2, RJ1.Y-
unnamed: R61.2, RJ1.G-
P2.7: R72.2
POW_SMOOTHIE_HOT: D3.3 (A), POWER1.1, Q10.2 (D)
PWM0: R239.2
PWM1: R71.2
RD+: C56.1, IC8.23 (RX+), R56.2, RJ1.RD+
RD-: C57.1, IC8.22 (RX-), R57.2, RJ1.RD-
RSTOUT: IC8.15 (NRST)
TD+: C54.1, IC8.21 (TX+), R54.2, RJ1.TD+
TD-: C55.1, IC8.20 (TX-), R55.2, RJ1.TD-
VBB: C63.1, D3.2 (K), D4.C, D5.C, Q10.3 (S), R78.2
VUSB: D1.2

Notes on the sheet:
carryover SmoothieBoard ver 1.0
