natuition/Smoothieboard/MOTHERBOARD_SHEET4.kicad_sch

## KiCad design MOTHERBOARD_SHEET4.kicad_sch (2022-07-20)

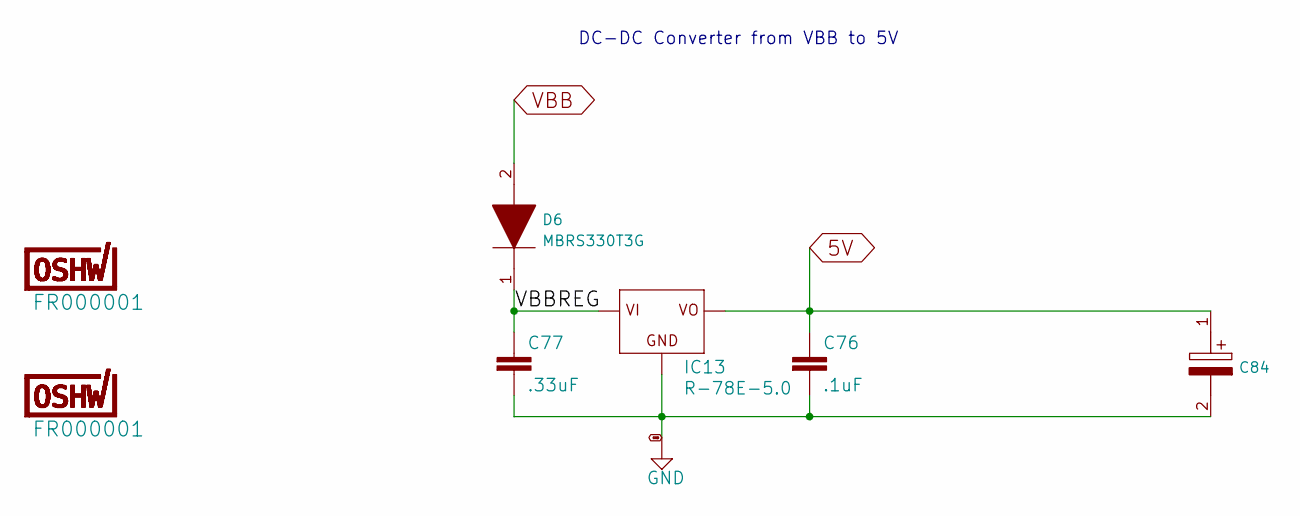
[picture p6: schematic MOTHERBOARD_SHEET4.kicad_sch]

Parts:
C76: .1uF; C0603
C77: .33uF; C0603
C84: EDK107M035A9HAA; CAPAE660X800N; Mouser Part Number 80-EDK107M035A9HAA
D6: MBRS330T3G; DIOM7958X256N; Mouser Part Number 863-MBRS330T3G
IC13: R-78E-5.0; R-78
U$103: FR000001; CERT-SMALL-SILK
U$104: FR000001; CERT-MED-SILK

Connections:
5V: C76.1, C84.1, IC13.3 (VO)
GND: C76.2, C77.2, C84.2, IC13.2 (GND)
VBB: D6.2
VBBREG: C77.1, D6.1, IC13.1 (VI)

Notes on the sheet:
DC-DC Converter from VBB to 5V
